MrTreev/EngineeringCapstoneProject/README.md

# EngineeringCapstoneProject

RMIT Engineering Capstone Project 2022

An investigation into materials and components for use in wearable technologies and the development of a holistic health monitoring system
