MrTreev/EngineeringCapstoneProject/02ProgressReport/Images/Figure 6.png

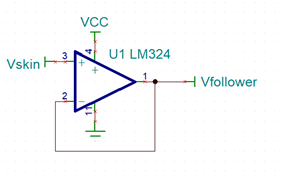
02ProgressReport/Images/Figure 6.png
