MrTreev/EngineeringCapstoneProject/02ProgressReport/Images/Figure 11.png

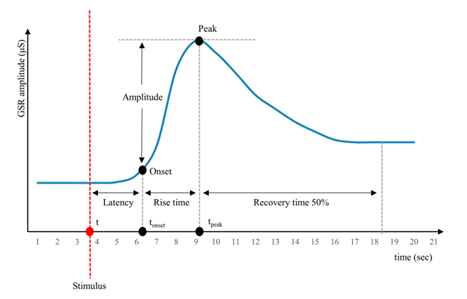
02ProgressReport/Images/Figure 11.png
