MrTreev/EngineeringCapstoneProject/02ProgressReport/Images/Figure 16.jpg

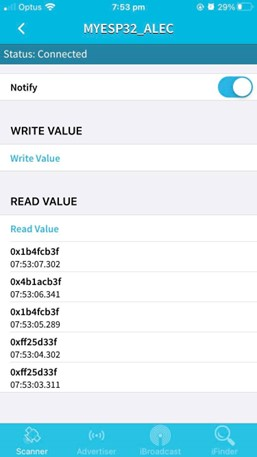
02ProgressReport/Images/Figure 16.jpg
