MrTreev/EngineeringCapstoneProject/02ProgressReport/Images/Figure 18.png

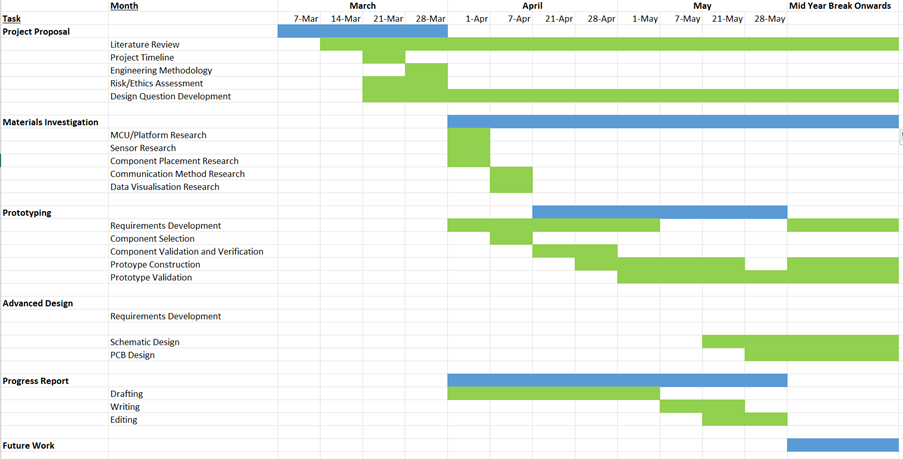
02ProgressReport/Images/Figure 18.png
