MrTreev/EngineeringCapstoneProject/02ProgressReport/Images/Figure 19.png

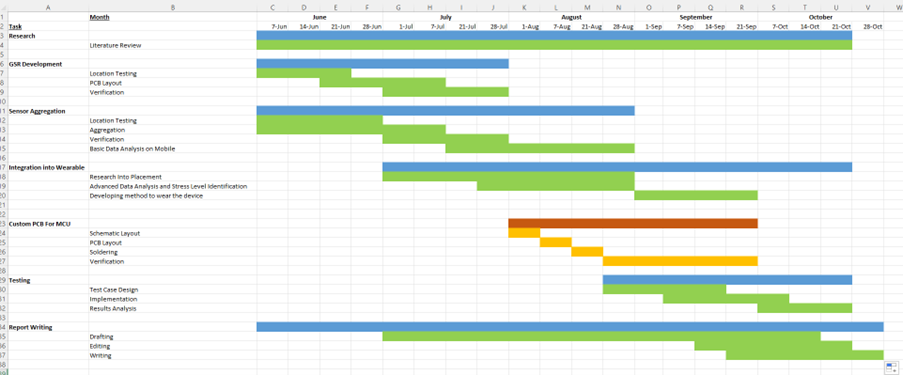
02ProgressReport/Images/Figure 19.png
