MrTreev/EngineeringCapstoneProject/02ProgressReport/Images/MCU Pin Connections.png

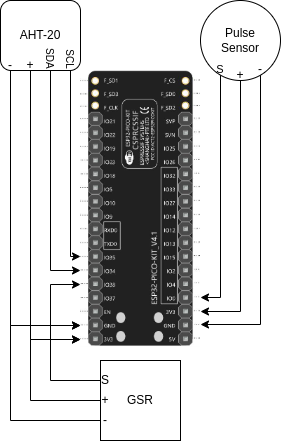
02ProgressReport/Images/MCU Pin Connections.png
