MrTreev/EngineeringCapstoneProject/02ProgressReport/Images/TempAndHumidity.png

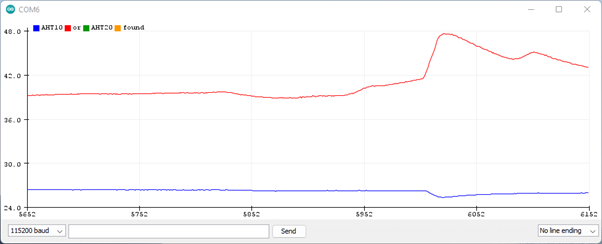
02ProgressReport/Images/TempAndHumidity.png
