MrTreev/EngineeringCapstoneProject/04FinalReport/images/AdvancedPCBBotView.png

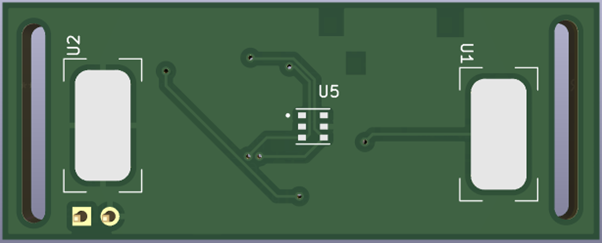
04FinalReport/images/AdvancedPCBBotView.png
