MrTreev/EngineeringCapstoneProject/04FinalReport/images/AdvancedPCBDesign.png

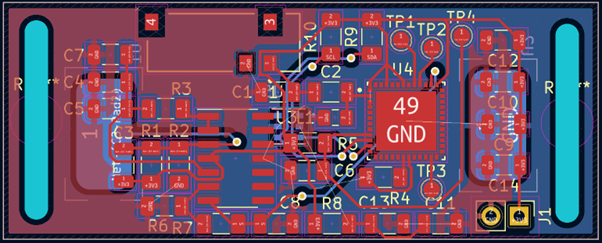
04FinalReport/images/AdvancedPCBDesign.png
