MrTreev/EngineeringCapstoneProject/04FinalReport/images/AdvancedPCBSchematic.png

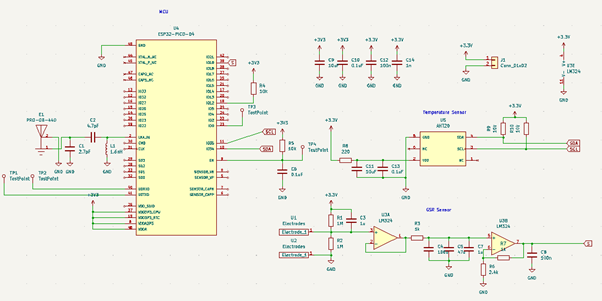
04FinalReport/images/AdvancedPCBSchematic.png
