MrTreev/EngineeringCapstoneProject/04FinalReport/images/AdvancedPCBTopView.png

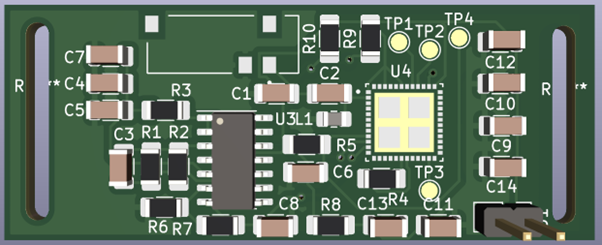
04FinalReport/images/AdvancedPCBTopView.png
