MrTreev/EngineeringCapstoneProject/04FinalReport/images/AHT20TypicalApplication.png

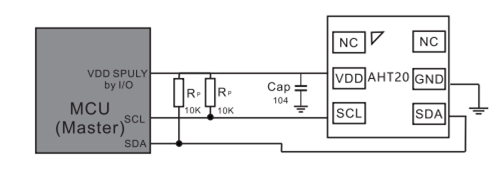
04FinalReport/images/AHT20TypicalApplication.png
