MrTreev/EngineeringCapstoneProject/04FinalReport/images/AmmeterConnection.jpg

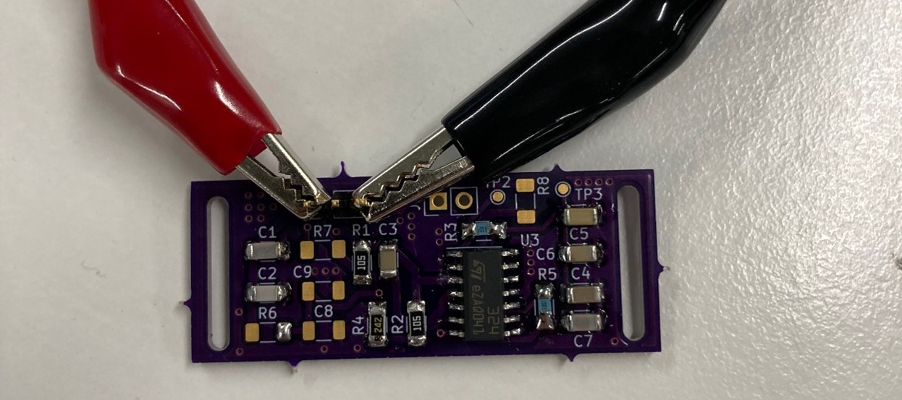
04FinalReport/images/AmmeterConnection.jpg
