MrTreev/EngineeringCapstoneProject/04FinalReport/images/CustomGSRSeeed.png

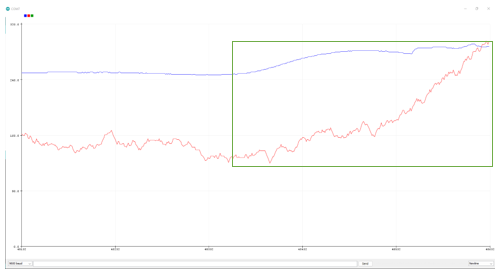
04FinalReport/images/CustomGSRSeeed.png
