MrTreev/EngineeringCapstoneProject/04FinalReport/images/DataPostSnippet.png

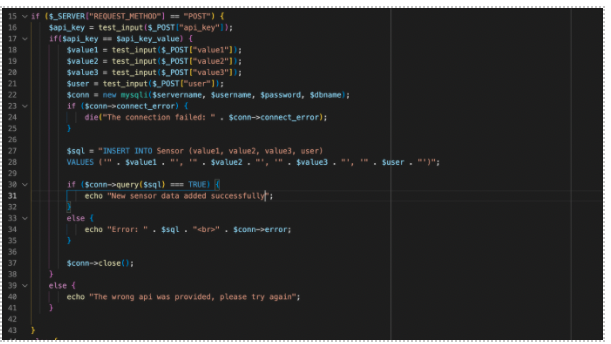
04FinalReport/images/DataPostSnippet.png
