MrTreev/EngineeringCapstoneProject/04FinalReport/images/DeviceBack.png

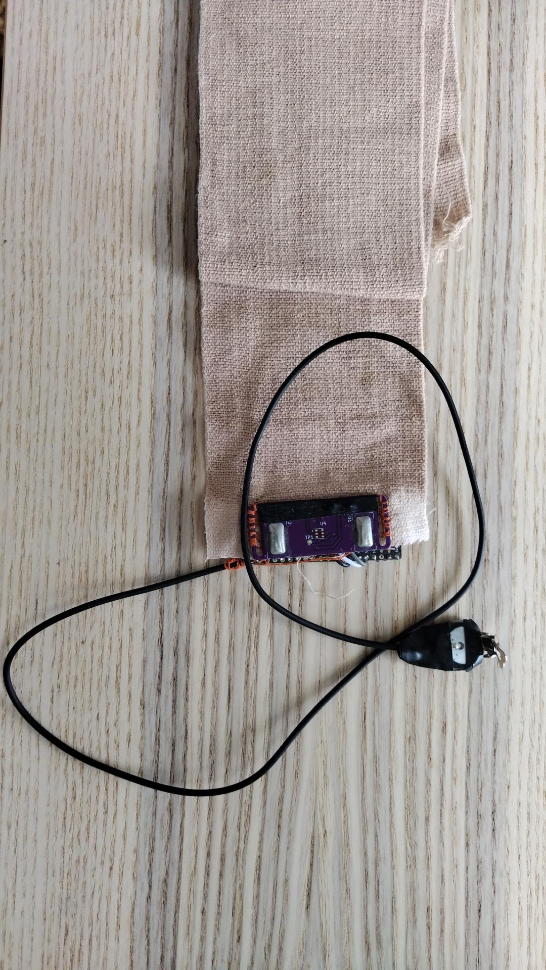
04FinalReport/images/DeviceBack.png
