MrTreev/EngineeringCapstoneProject/04FinalReport/images/DeviceFront.png

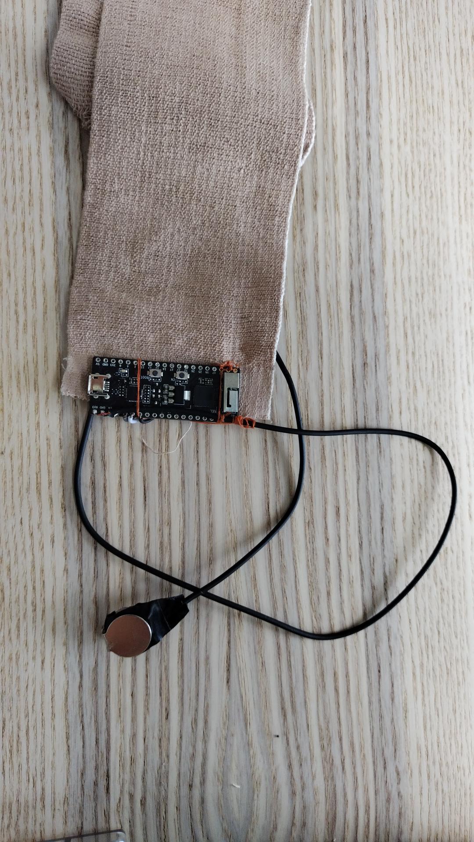
04FinalReport/images/DeviceFront.png
