MrTreev/EngineeringCapstoneProject/04FinalReport/images/DualCoreESP32.png

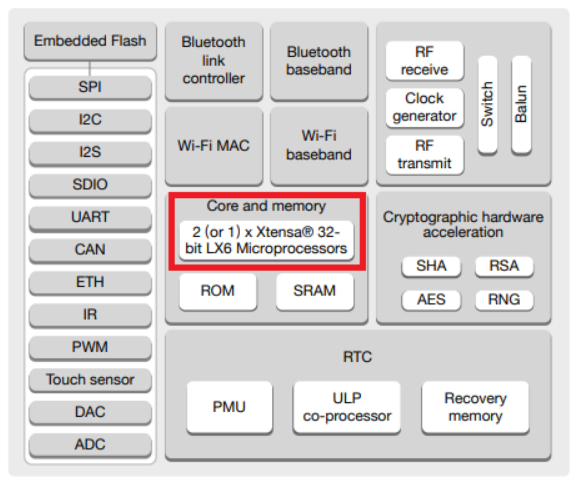
04FinalReport/images/DualCoreESP32.png
