MrTreev/EngineeringCapstoneProject/04FinalReport/images/FigmaDesigns.png

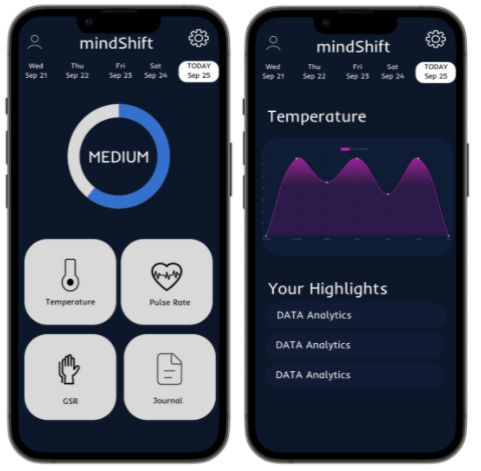
04FinalReport/images/FigmaDesigns.png
