MrTreev/EngineeringCapstoneProject/04FinalReport/images/FinalElectrodes.jpg

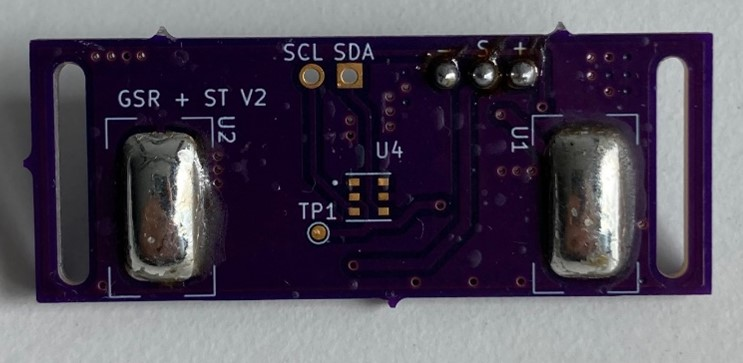
04FinalReport/images/FinalElectrodes.jpg
