MrTreev/EngineeringCapstoneProject/04FinalReport/images/FlexBottomSide.jpg

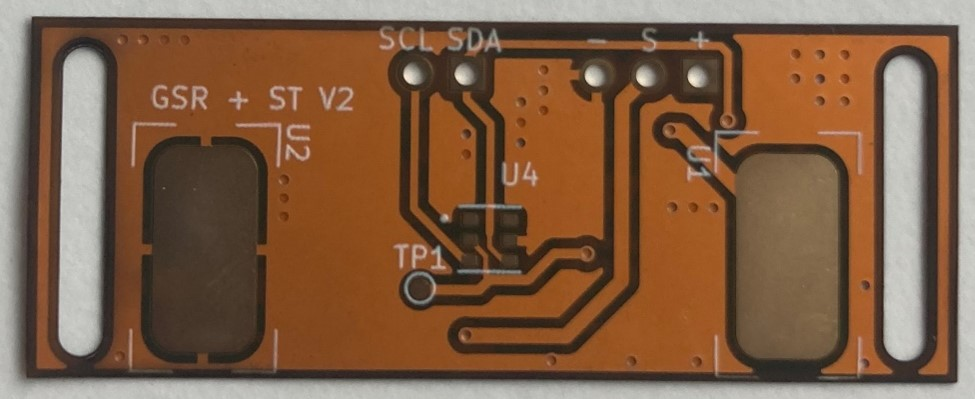
04FinalReport/images/FlexBottomSide.jpg
