MrTreev/EngineeringCapstoneProject/04FinalReport/images/FlexTopSide.jpg

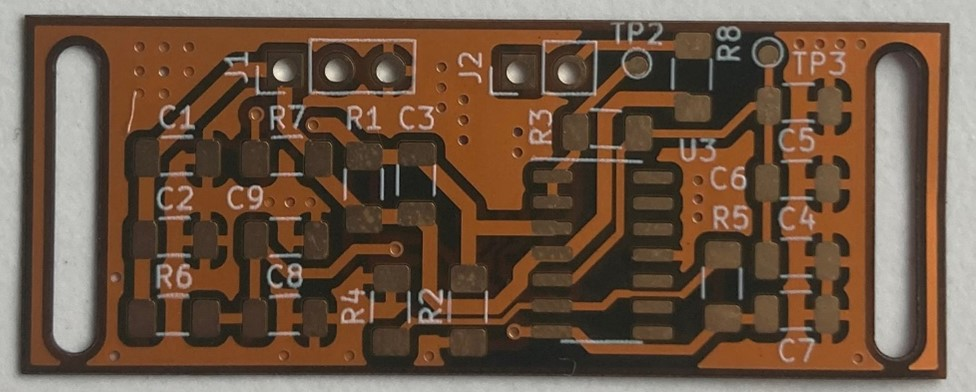
04FinalReport/images/FlexTopSide.jpg
