MrTreev/EngineeringCapstoneProject/04FinalReport/images/GenericBotView.png

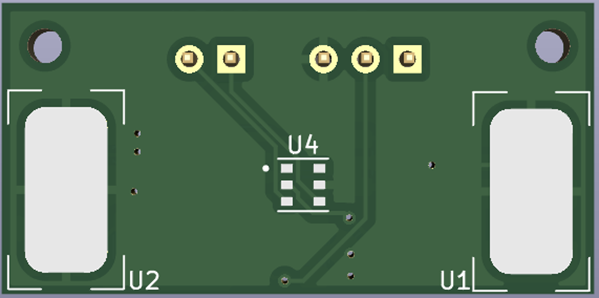
04FinalReport/images/GenericBotView.png
