MrTreev/EngineeringCapstoneProject/04FinalReport/images/GenericMountingHoles.png

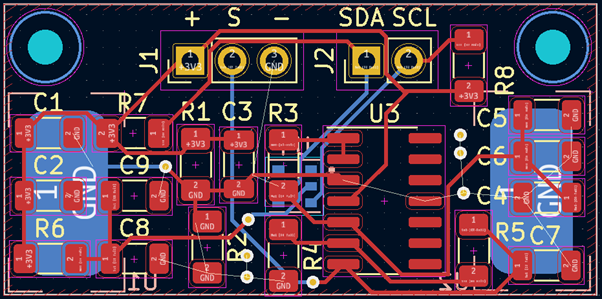
04FinalReport/images/GenericMountingHoles.png
