MrTreev/EngineeringCapstoneProject/04FinalReport/images/GenericTopView.png

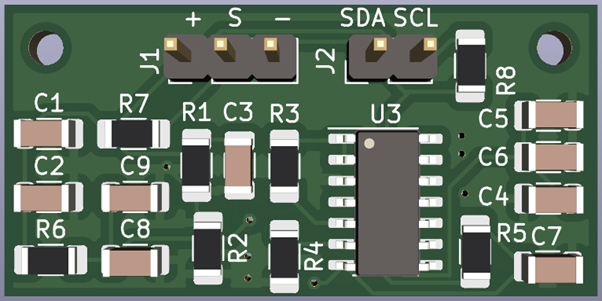
04FinalReport/images/GenericTopView.png
