MrTreev/EngineeringCapstoneProject/04FinalReport/images/GroundPlanes.png

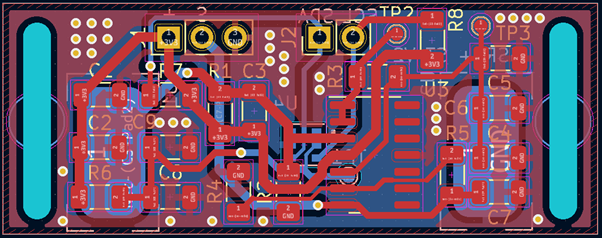
04FinalReport/images/GroundPlanes.png
