MrTreev/EngineeringCapstoneProject/04FinalReport/images/HighLevelSystemDesign.png

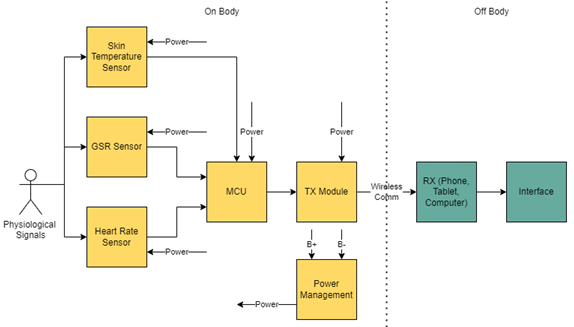
04FinalReport/images/HighLevelSystemDesign.png
