MrTreev/EngineeringCapstoneProject/04FinalReport/images/KiCadSchematic.png

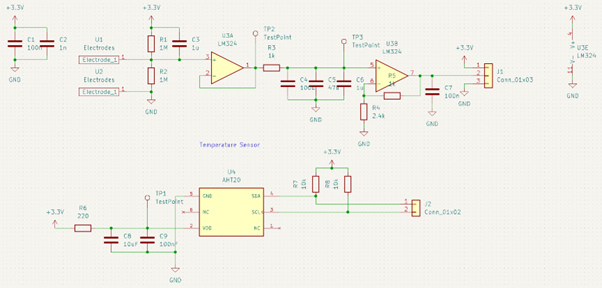
04FinalReport/images/KiCadSchematic.png
