MrTreev/EngineeringCapstoneProject/04FinalReport/images/PCBDesignProcess.png

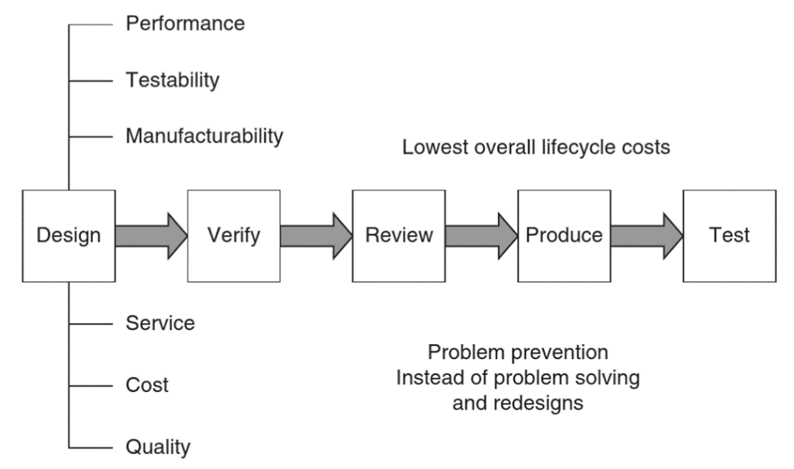
04FinalReport/images/PCBDesignProcess.png
