MrTreev/EngineeringCapstoneProject/04FinalReport/images/PogoPinExample.png

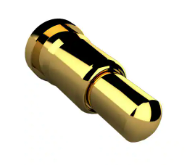
04FinalReport/images/PogoPinExample.png
