MrTreev/EngineeringCapstoneProject/04FinalReport/images/PositioningEarLobe.png

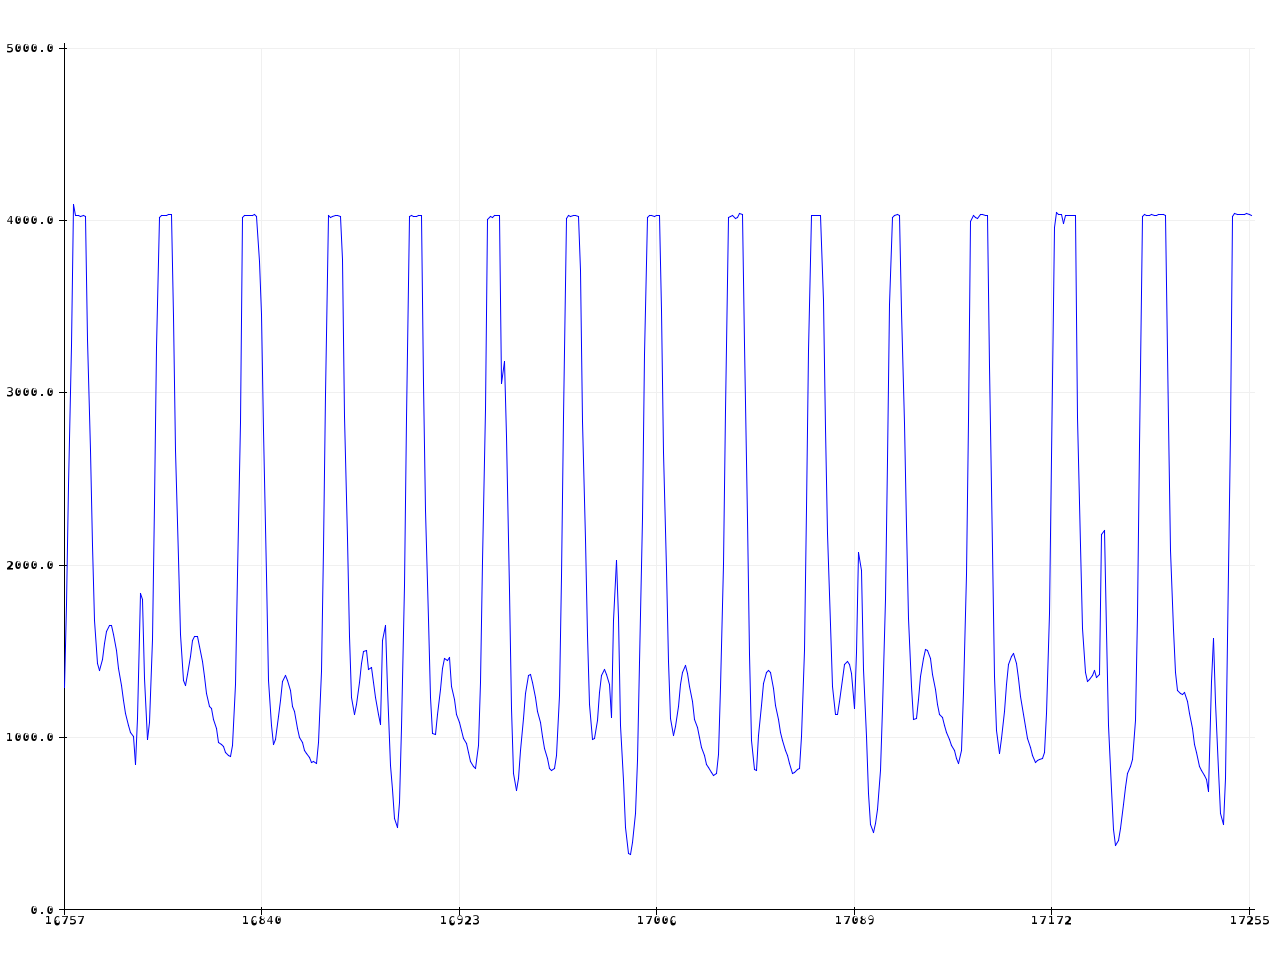
04FinalReport/images/PositioningEarLobe.png
