MrTreev/EngineeringCapstoneProject/04FinalReport/images/PositioningEarLobeMovement.png

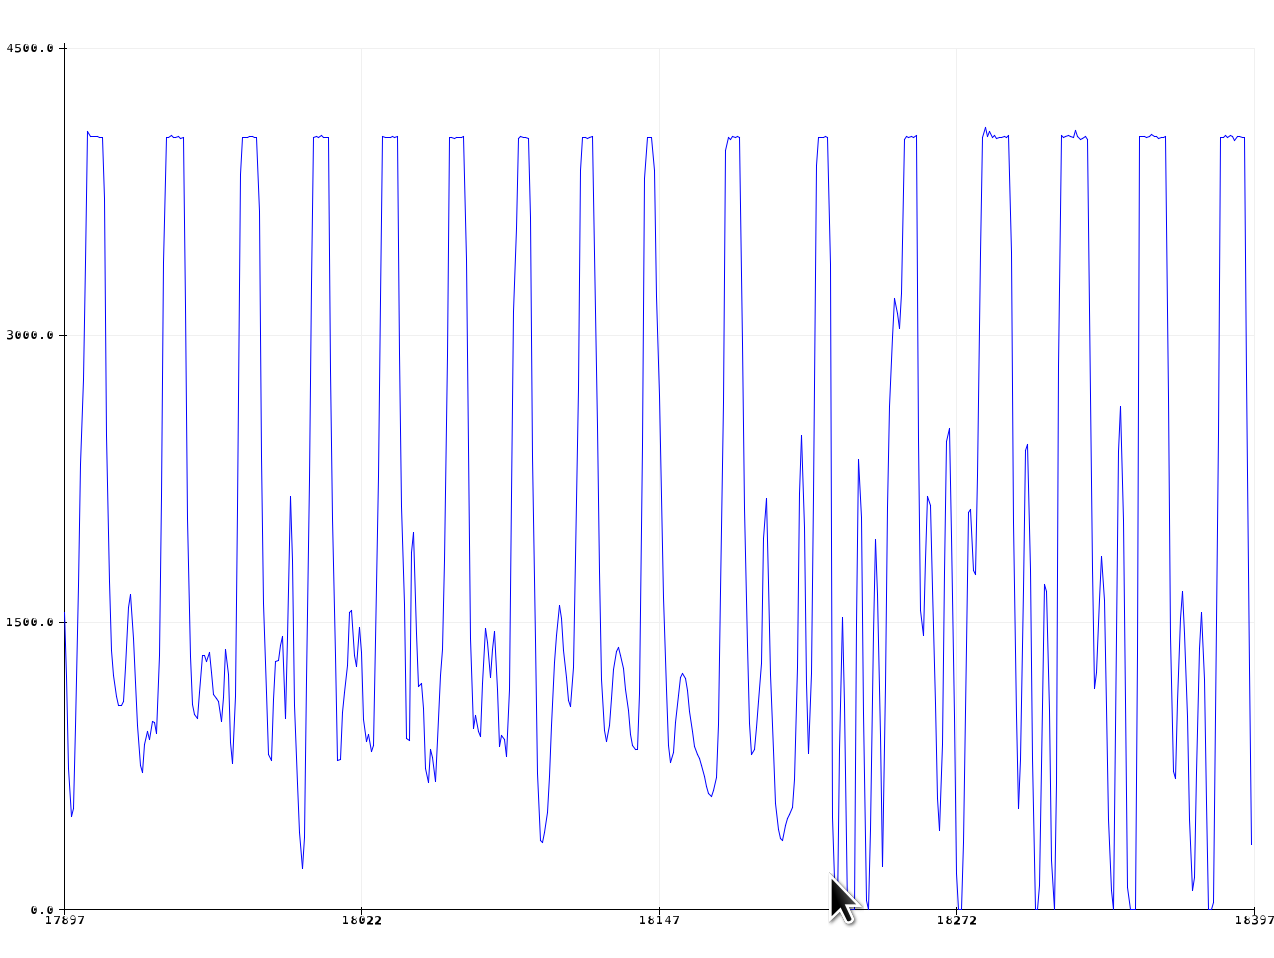
04FinalReport/images/PositioningEarLobeMovement.png
