MrTreev/EngineeringCapstoneProject/04FinalReport/images/PositioningElbow.png

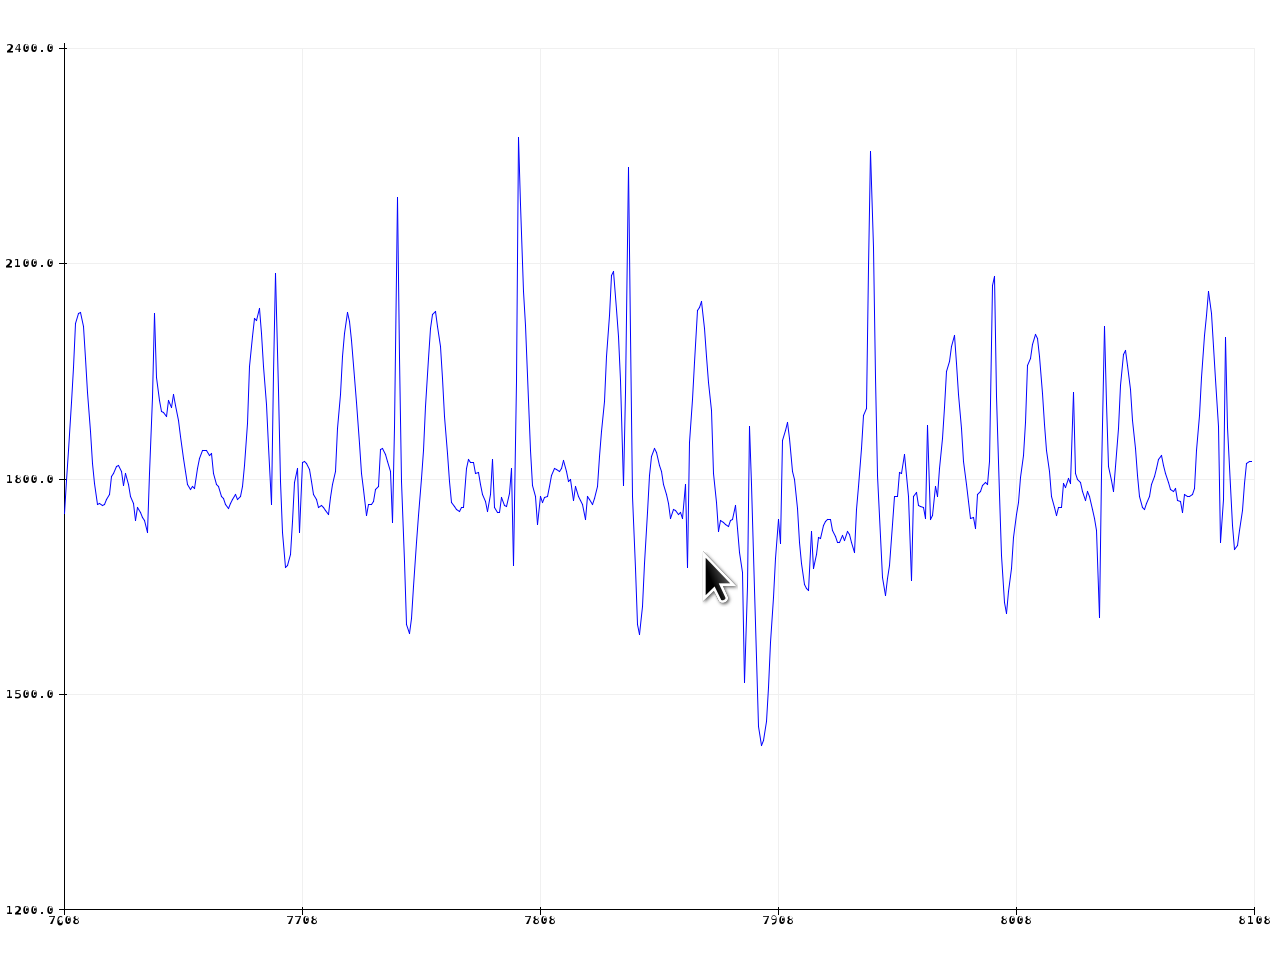
04FinalReport/images/PositioningElbow.png
