MrTreev/EngineeringCapstoneProject/04FinalReport/images/PositioningMidArmMovement.png

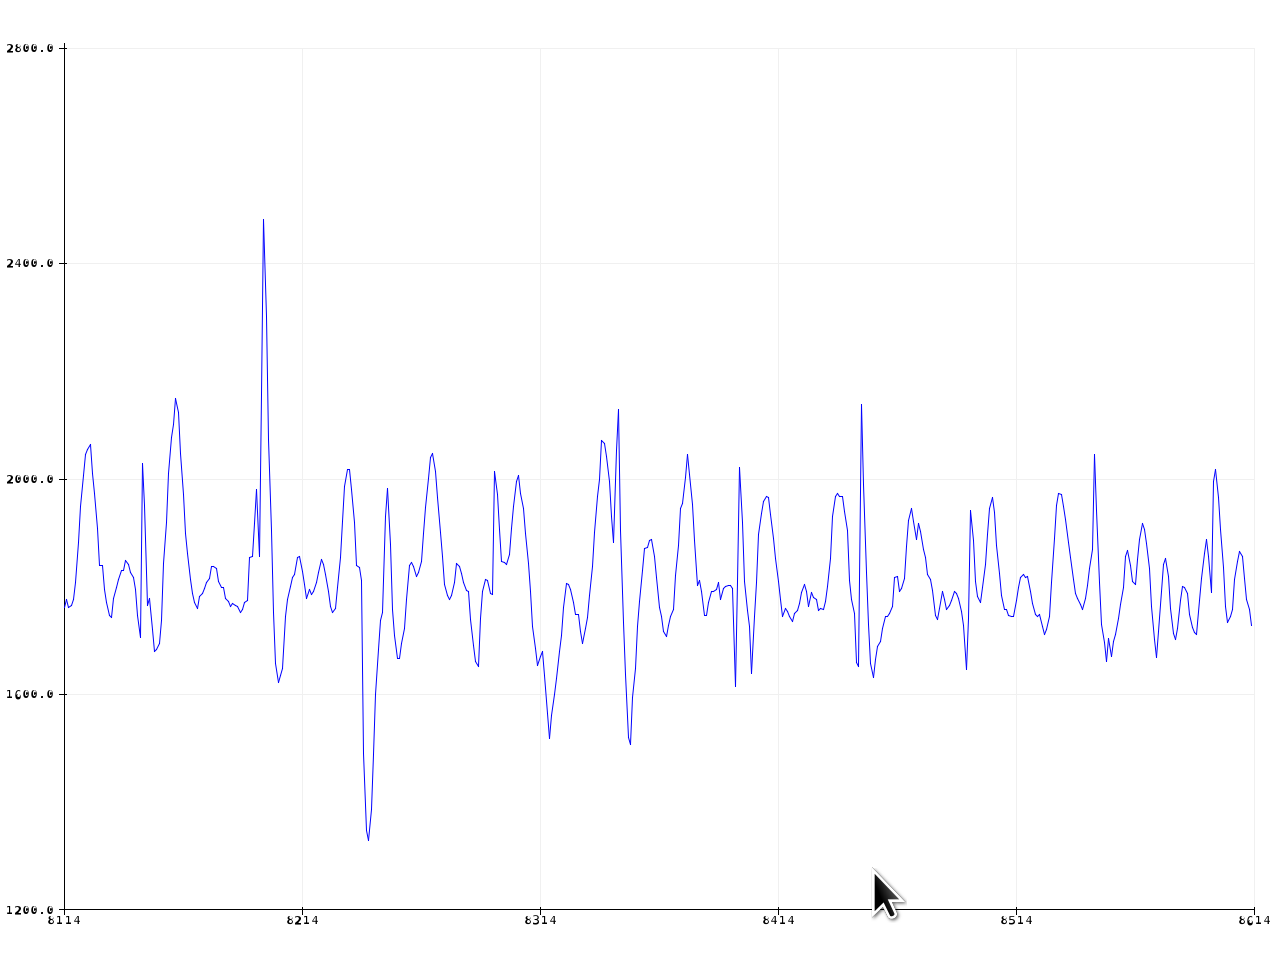
04FinalReport/images/PositioningMidArmMovement.png
