MrTreev/EngineeringCapstoneProject/04FinalReport/images/PositioningWristMildMovement.png

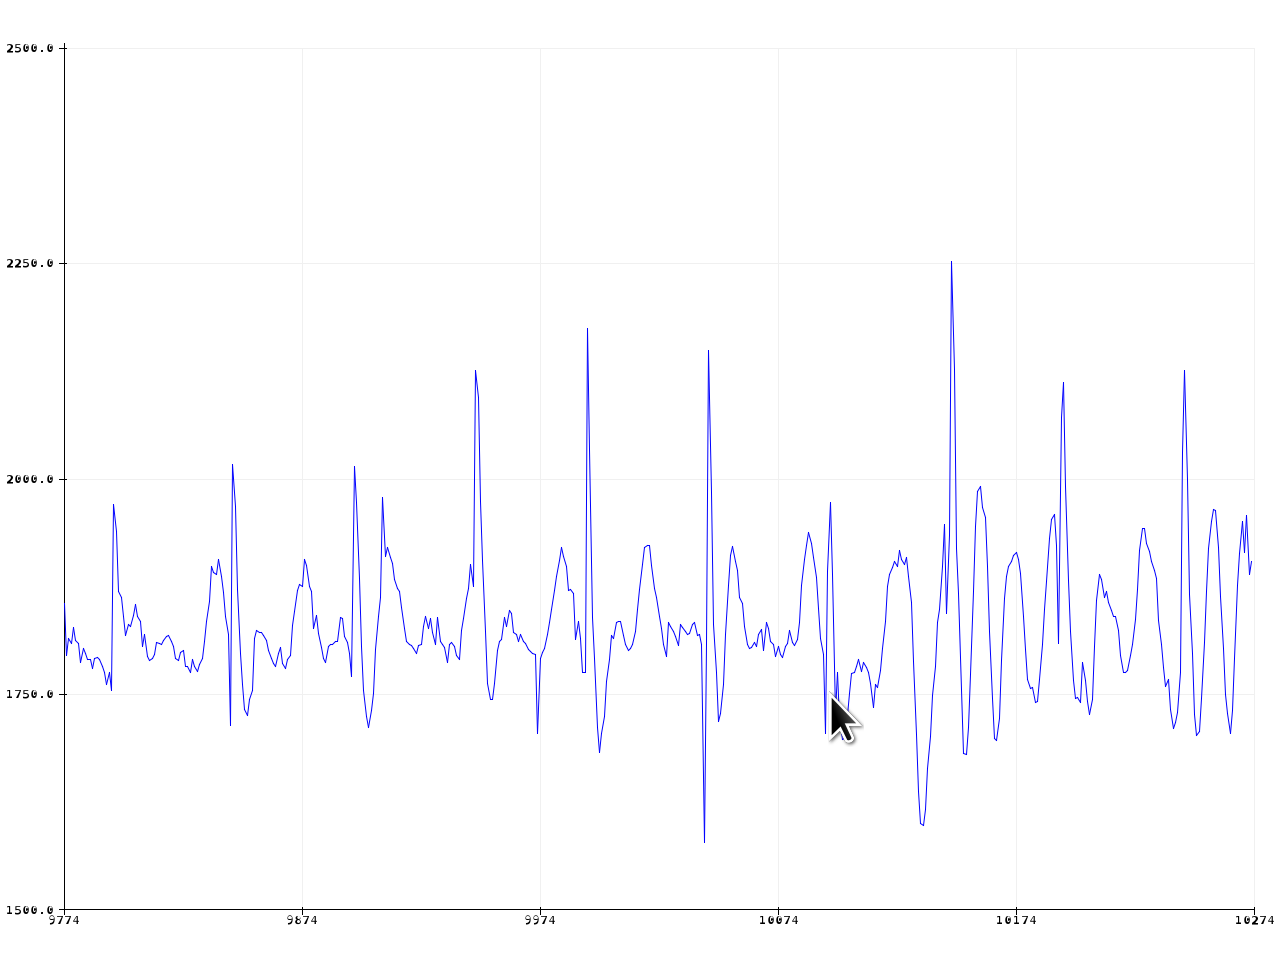
04FinalReport/images/PositioningWristMildMovement.png
