MrTreev/EngineeringCapstoneProject/04FinalReport/images/PowerSupplyAndAmmeter.jpg

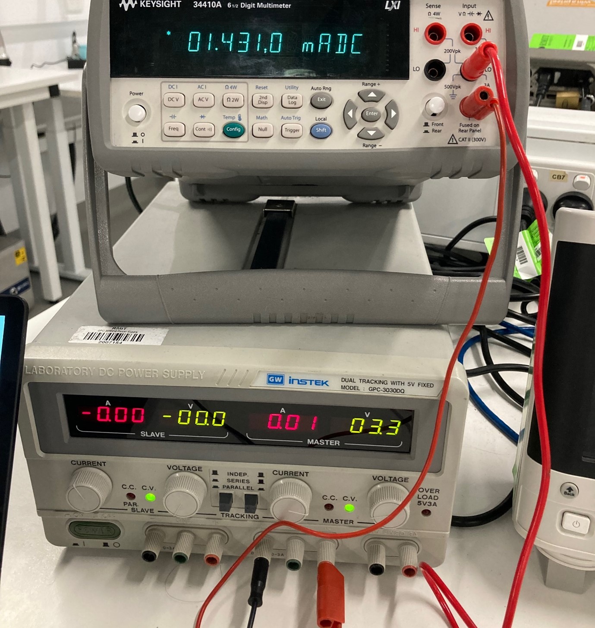
04FinalReport/images/PowerSupplyAndAmmeter.jpg
