MrTreev/EngineeringCapstoneProject/04FinalReport/images/PrototypeSchematic.png

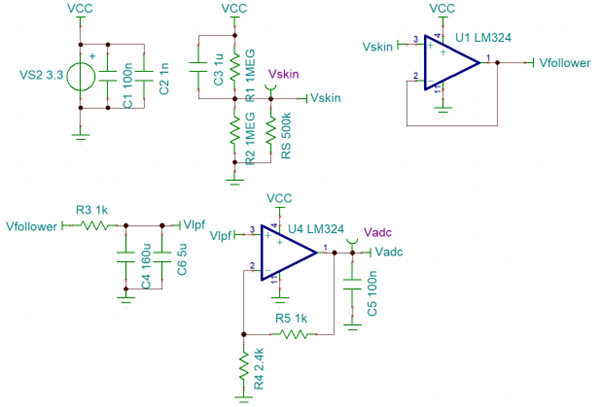
04FinalReport/images/PrototypeSchematic.png
