MrTreev/EngineeringCapstoneProject/04FinalReport/images/RawPulseBPM.png

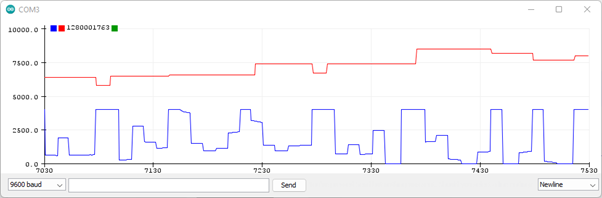
04FinalReport/images/RawPulseBPM.png
