MrTreev/EngineeringCapstoneProject/04FinalReport/images/RigidBottomSide.jpg

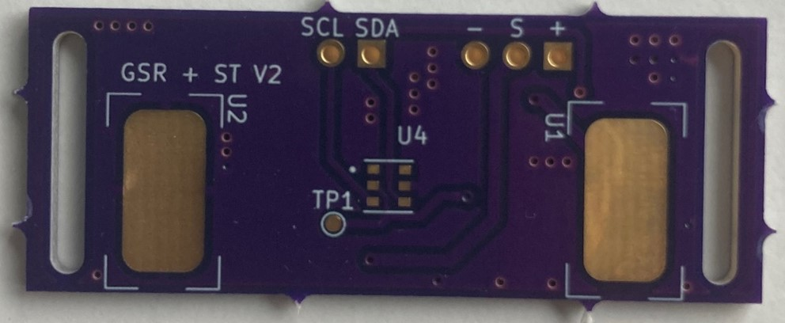
04FinalReport/images/RigidBottomSide.jpg
