MrTreev/EngineeringCapstoneProject/04FinalReport/images/RigidTopSide.jpg

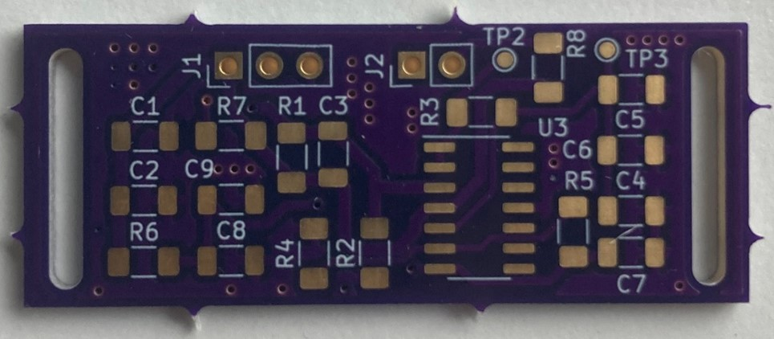
04FinalReport/images/RigidTopSide.jpg
