MrTreev/EngineeringCapstoneProject/04FinalReport/images/RootCausePCBAnalysis.png

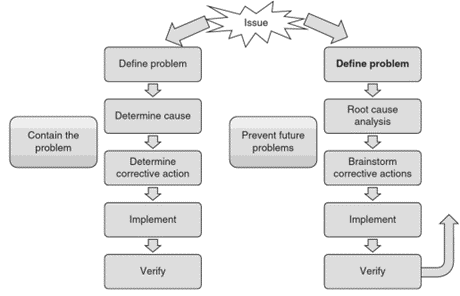
04FinalReport/images/RootCausePCBAnalysis.png
