MrTreev/EngineeringCapstoneProject/04FinalReport/images/SampleDataFromDatabase.png

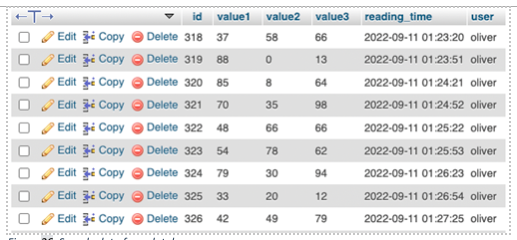
04FinalReport/images/SampleDataFromDatabase.png
