MrTreev/EngineeringCapstoneProject/04FinalReport/images/SchematicToPCB.png

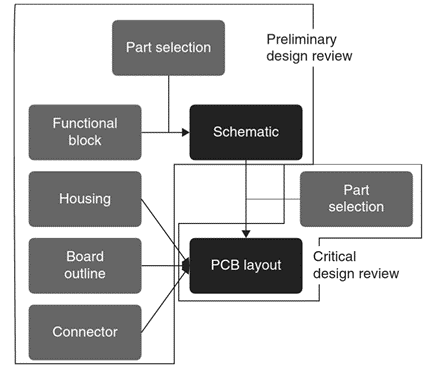
04FinalReport/images/SchematicToPCB.png
