MrTreev/EngineeringCapstoneProject/04FinalReport/images/SoftwareArchitectureFlowchart.png

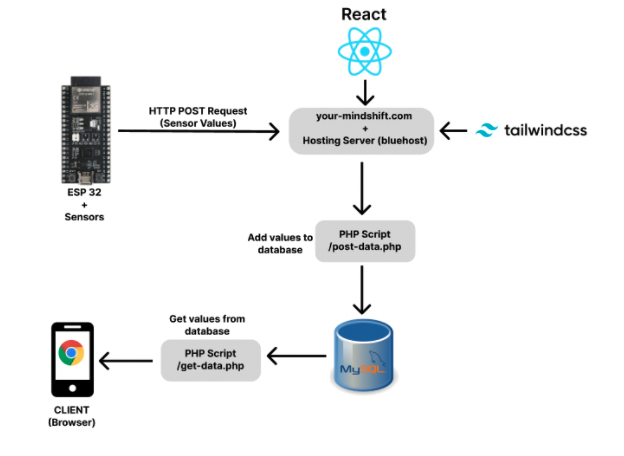
04FinalReport/images/SoftwareArchitectureFlowchart.png
