MrTreev/EngineeringCapstoneProject/04FinalReport/images/StrapBotView.png

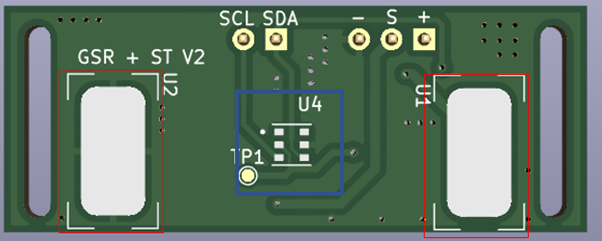
04FinalReport/images/StrapBotView.png
