MrTreev/EngineeringCapstoneProject/04FinalReport/images/StrapMountingHoles.png

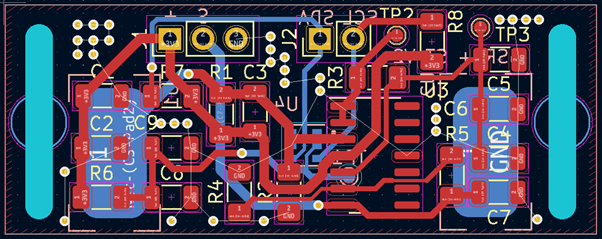
04FinalReport/images/StrapMountingHoles.png
