MrTreev/EngineeringCapstoneProject/04FinalReport/images/StrapTopView.png

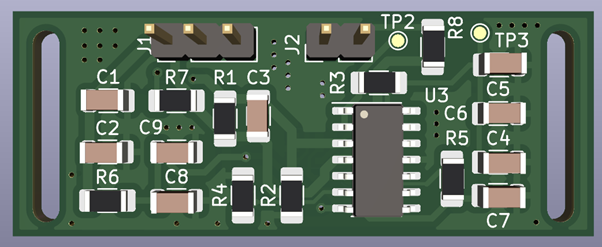
04FinalReport/images/StrapTopView.png
