MrTreev/EngineeringCapstoneProject/04FinalReport/images/WornDevice.jpg

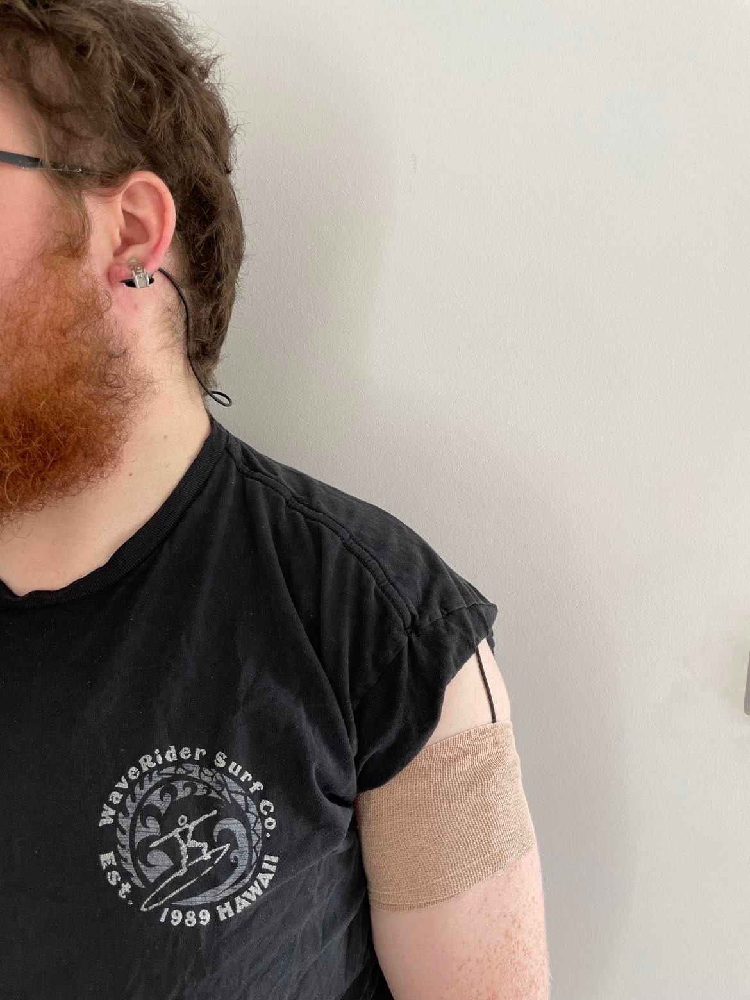
04FinalReport/images/WornDevice.jpg
