MrTreev/EngineeringCapstoneProject/Resources/Datasheets/ESP32-PICO/1_195329ba3fc.jpg

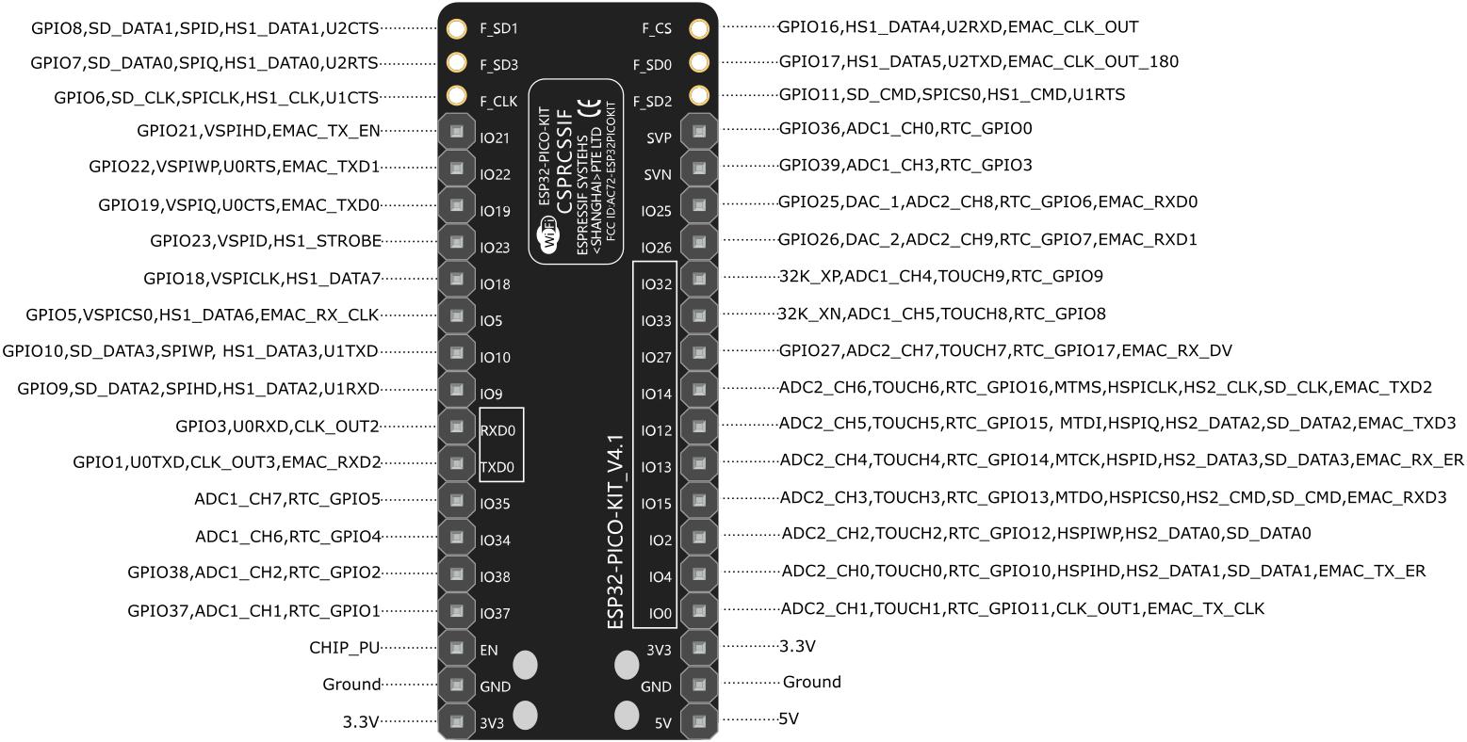
Resources/Datasheets/ESP32-PICO/1_195329ba3fc.jpg
