MrTreev/EngineeringCapstoneProject/Resources/Datasheets/ESP32-PICO/ProtocolDiagram.png

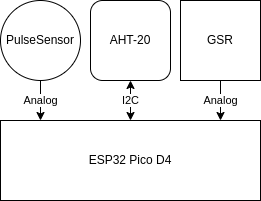
Resources/Datasheets/ESP32-PICO/ProtocolDiagram.png
