MrTreev/EngineeringCapstoneProject/Resources/Papers/SYmpathetic-vs-parasympathetic-1.jpg

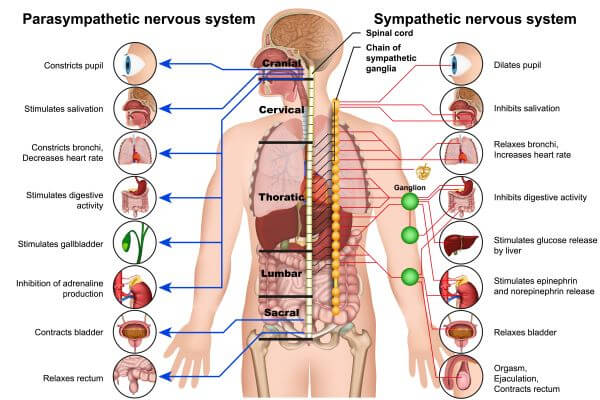
Resources/Papers/SYmpathetic-vs-parasympathetic-1.jpg
