MrTreev/EngineeringCapstoneProject/04FinalReport/images/ReactComponentTree.png

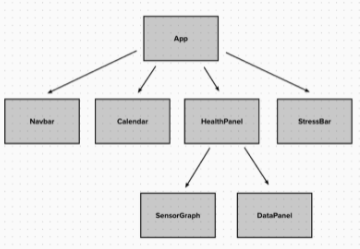
04FinalReport/images/ReactComponentTree.png
