MrTreev/EngineeringCapstoneProject/Resources/Datasheets/ESP32-PICO/WiringDiagram.png

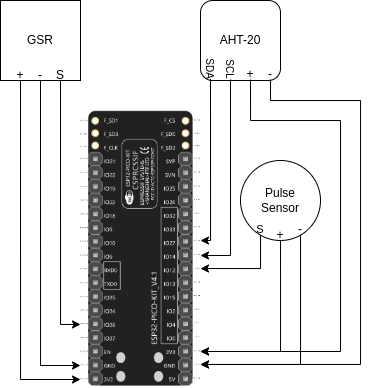
Resources/Datasheets/ESP32-PICO/WiringDiagram.png
