MrTreev/EngineeringCapstoneProject/Testing/Matlab/SensorDataTest2.csv

20013 | 342.00 | 1153 | 0 | 2022-10-10 18:23:35 | oliver
20014 | 857.00 | 120 | 0 | 2022-10-10 18:23:42 | oliver
20015 | 850.00 | 126 | 0 | 2022-10-10 18:23:49 | oliver
20016 | 842.00 | 121 | 0 | 2022-10-10 18:23:56 | oliver
20017 | 835.00 | 128 | 0 | 2022-10-10 18:24:03 | oliver
20018 | 829.00 | 126 | 0 | 2022-10-10 18:24:10 | oliver
20019 | 823.00 | 128 | 0 | 2022-10-10 18:24:17 | oliver
20020 | 822.00 | 118 | 0 | 2022-10-10 18:24:23 | oliver
20021 | 819.00 | 109 | 0 | 2022-10-10 18:24:30 | oliver
20022 | 815.00 | 126 | 0 | 2022-10-10 18:24:37 | oliver
20023 | 817.00 | 111 | 0 | 2022-10-10 18:24:44 | oliver
20024 | 808.00 | 131 | 0 | 2022-10-10 18:24:51 | oliver
20025 | 812.00 | 125 | 0 | 2022-10-10 18:24:57 | oliver
20026 | 816.00 | 129 | 0 | 2022-10-10 18:25:04 | oliver
20027 | 815.00 | 130 | 0 | 2022-10-10 18:25:11 | oliver
20028 | 817.00 | 103 | 0 | 2022-10-10 18:25:18 | oliver
20029 | 816.00 | 134 | 0 | 2022-10-10 18:25:25 | oliver
20030 | 815.00 | 123 | 0 | 2022-10-10 18:25:32 | oliver
20031 | 814.00 | 109 | 0 | 2022-10-10 18:25:39 | oliver
20032 | 819.00 | 107 | 0 | 2022-10-10 18:25:46 | oliver
20033 | 817.00 | 120 | 0 | 2022-10-10 18:25:52 | oliver
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
