MrTreev/EngineeringCapstoneProject/Testing/Matlab/SensorDataTest.csv

318 | 37 | 58 | 66 | 2022-09-11 01:23:20 | oliver
319 | 88 | 0 | 13 | 2022-09-11 01:23:51 | oliver
320 | 85 | 8 | 64 | 2022-09-11 01:24:21 | oliver
321 | 70 | 35 | 98 | 2022-09-11 01:24:52 | oliver
322 | 48 | 66 | 66 | 2022-09-11 01:25:22 | oliver
323 | 54 | 78 | 62 | 2022-09-11 01:25:53 | oliver
324 | 79 | 30 | 94 | 2022-09-11 01:26:23 | oliver
325 | 33 | 20 | 12 | 2022-09-11 01:26:54 | oliver
326 | 42 | 49 | 79 | 2022-09-11 01:27:25 | oliver
327 | 79 | 23 | 48 | 2022-09-11 01:27:55 | oliver
328 | 12 | 8 | 17 | 2022-09-11 01:28:26 | oliver
329 | 56 | 58 | 36 | 2022-09-11 01:28:57 | oliver
330 | 13 | 74 | 27 | 2022-09-11 02:02:25 | oliver
331 | 89 | 34 | 3 | 2022-09-11 02:03:21 | oliver
332 | 3 | 18 | 4 | 2022-09-11 02:03:52 | oliver
333 | 59 | 7 | 3 | 2022-09-11 02:34:42 | oliver
334 | 58 | 12 | 89 | 2022-09-11 02:35:30 | oliver
335 | 16 | 96 | 2 | 2022-09-11 02:36:00 | oliver
336 | 76 | 65 | 71 | 2022-09-11 02:45:20 | oliver
337 | 32 | 79 | 14 | 2022-09-11 02:46:22 | alec
338 | 98 | 12 | 33 | 2022-09-11 02:46:52 | alec
339 | 98 | 38 | 18 | 2022-09-11 02:47:38 | alec
340 | 85 | 98 | 11 | 2022-09-11 02:47:49 | alec
341 | 17 | 67 | 51 | 2022-09-11 02:48:00 | alec
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
