MrTreev/EngineeringCapstoneProject/04FinalReport/images/BPMVerification.png

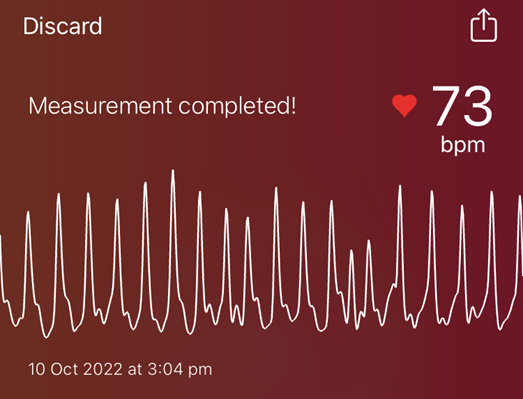
04FinalReport/images/BPMVerification.png
