MrTreev/EngineeringCapstoneProject/04FinalReport/images/Results.png

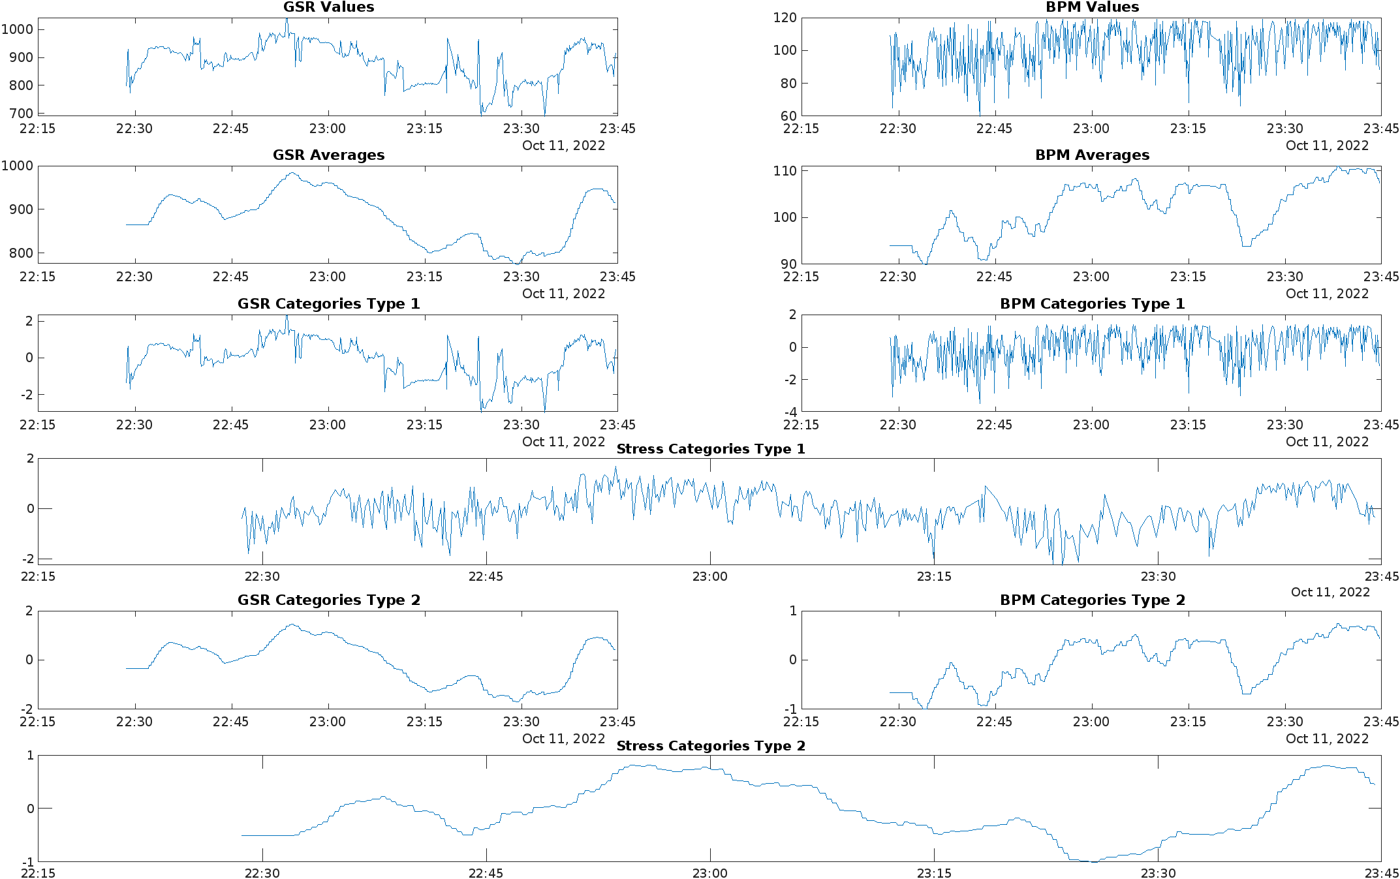
04FinalReport/images/Results.png
