MrTreev/EngineeringCapstoneProject/PCB Files/GSR + ST V2/GSR + ST V2.kicad_pcb

## KiCad design PCB Files/GSR + ST V2/GSR + ST V2.kicad_pcb (2022-08-03)

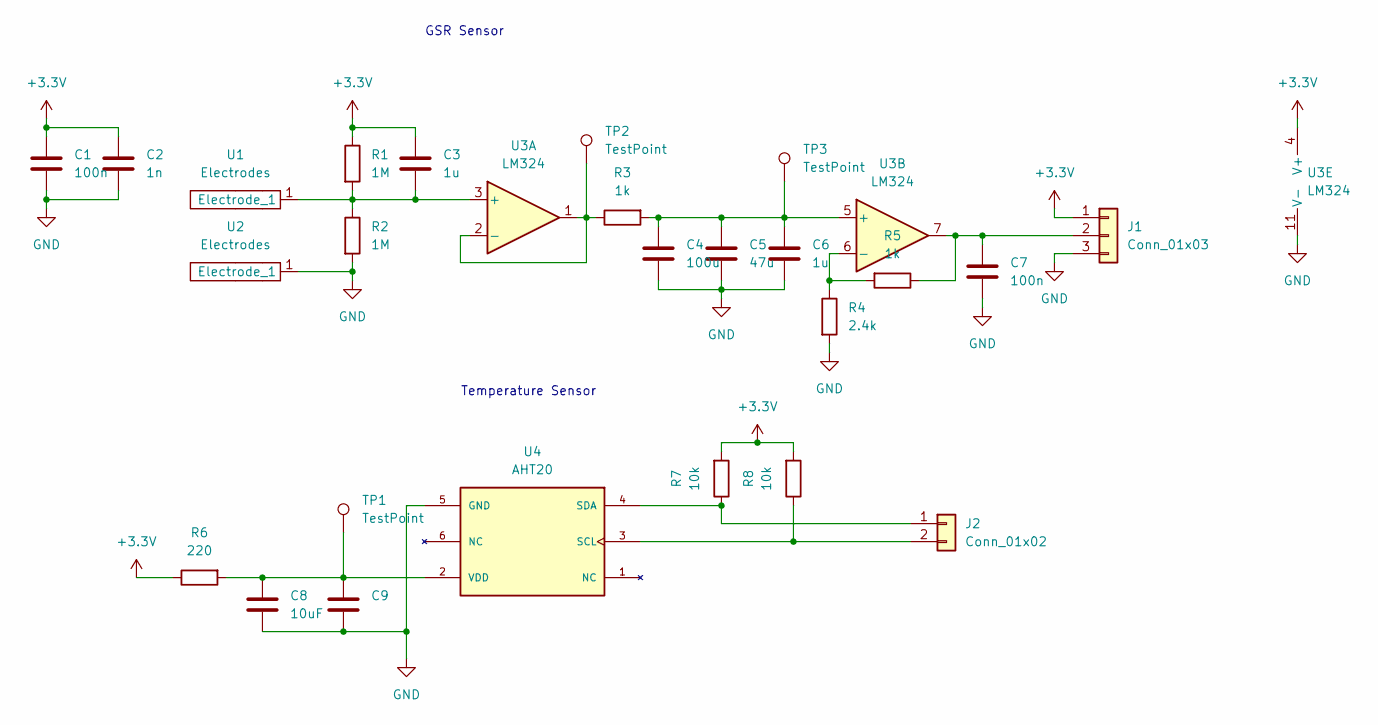
[picture p96: schematic GSR + ST V2.kicad_sch]

Parts:
C1, C7: 100n; C_1206_3216Metric
C2: 1n; C_1206_3216Metric
C3, C6: 1u; C_1206_3216Metric
C4: 100u; C_1206_3216Metric
C5: 47u; C_1206_3216Metric
C8: 10uF; C_1206_3216Metric
C9: C_1206_3216Metric
J1: Conn_01x03; PinHeader_1x03_P2.54mm_Vertical
J2: Conn_01x02; PinHeader_1x02_P2.54mm_Vertical
R1, R2: 1M; R_1206_3216Metric_Pad1.30x1.75mm_HandSolder
R3, R5: 1k; R_1206_3216Metric_Pad1.30x1.75mm_HandSolder
R4: 2.4k; R_1206_3216Metric_Pad1.30x1.75mm_HandSolder
R6: 220; R_1206_3216Metric_Pad1.30x1.75mm_HandSolder
R7, R8: 10k; R_1206_3216Metric_Pad1.30x1.75mm_HandSolder
TP1, TP2, TP3: TestPoint; TestPoint_Pad_D1.0mm
U1, U2: Electrodes; Electrode
U3: LM324; SOIC-14_3.9x8.7mm_P1.27mm
U4: AHT20; PSON100P300X300X110-6N; PARTREV V1.0

Connections:
+3V3: C1.1, C2.1, C3.1, J1.1, R1.1, R6.1, R7.2, R8.2, U3.4 (V+)
GND: C1.2, C2.2, C4.2, C5.2, C6.2, C7.2, C8.2, C9.2, J1.3, R2.2, R4.2, U2.1 (Electrode_1), U3.11 (V-), U4.5 (GND)
unnamed: C3.2, R1.2, R2.1, U1.1 (Electrode_1), U3.3 (+)
unnamed: C4.1, C5.1, C6.1, R3.2, TP3.1, U3.5 (+)
unnamed: C7.1, J1.2, R5.1, U3.7
unnamed: C8.1, C9.1, R6.2, TP1.1, U4.2 (VDD)
unnamed: J2.1, R7.1, U4.4 (SDA)
unnamed: J2.2, R8.1, U4.3 (SCL)
unnamed: R3.1, TP2.1, U3.1, U3.2 (-)
unnamed: R4.1, R5.2, U3.6 (-)

Notes on the sheet:
Temperature Sensor
GSR Sensor

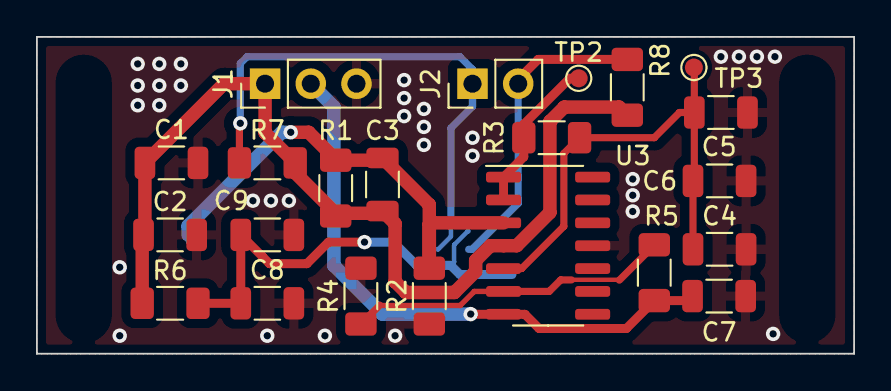
[picture p97: board GSR + ST V2.kicad_pcb from above]

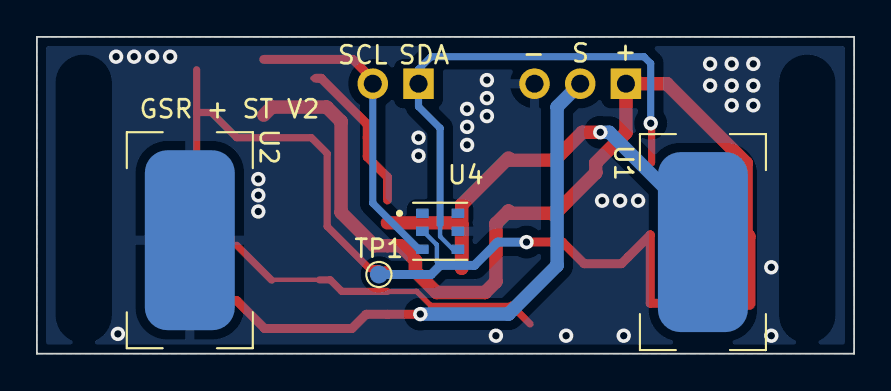
[picture p98: board GSR + ST V2.kicad_pcb from below]

Board: 2 copper layers, 45.4 x 17.6 mm, 26 parts (4 on the bottom side), 10 nets.
