MrTreev/EngineeringCapstoneProject/PCB Files/ESP32 PCB/ESP32 PCB.kicad_pcb

## KiCad design PCB Files/ESP32 PCB/ESP32 PCB.kicad_pcb (2022-08-01)

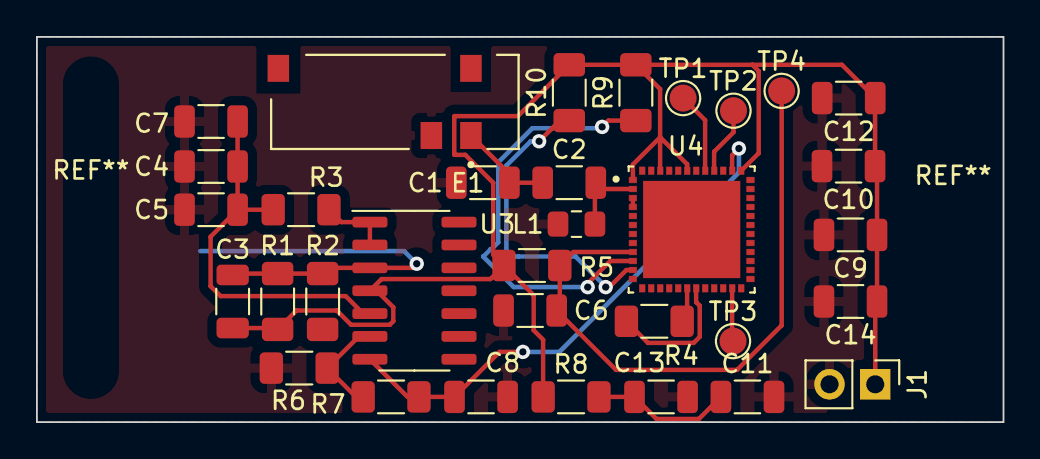
[picture p99: board ESP32 PCB.kicad_pcb from above]

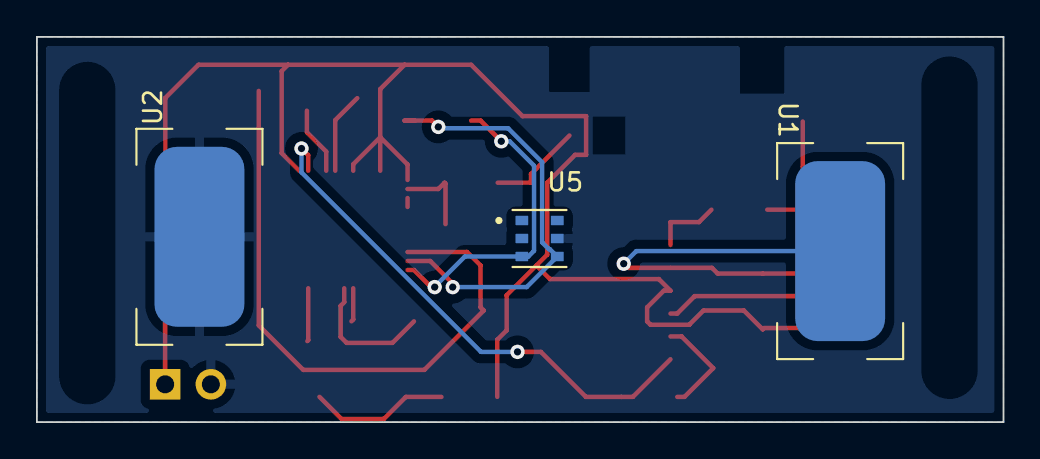
[picture p100: board ESP32 PCB.kicad_pcb from below]

Board: 2 copper layers, 53.7 x 21.4 mm, 36 parts (3 on the bottom side), 17 nets.

Parts:
C1: 2.7pF; C_1206_3216Metric
C2: 4.7pF; C_1206_3216Metric
C3, C7: 1u; C_1206_3216Metric
C4: 100u; C_1206_3216Metric
C5: 47u; C_1206_3216Metric
C6, C10, C13: 0.1uF; C_1206_3216Metric
C8, C12: 100n; C_1206_3216Metric
C9, C11: 10uF; C_1206_3216Metric
C14: 1n; C_1206_3216Metric
E1: PRO-OB-440; ANT_PRO-OB-440
J1: Conn_01x02; PinHeader_1x02_P2.54mm_Vertical
L1: 1.6nH; L_0805_2012Metric_Pad1.15x1.40mm_HandSolder
R1, R2: 1M; R_1206_3216Metric_Pad1.30x1.75mm_HandSolder
R3, R7: 1k; R_1206_3216Metric_Pad1.30x1.75mm_HandSolder
R4, R5: 10K; R_1206_3216Metric_Pad1.30x1.75mm_HandSolder
R6: 2.4k; R_1206_3216Metric_Pad1.30x1.75mm_HandSolder
R8: 220; R_1206_3216Metric_Pad1.30x1.75mm_HandSolder
R9, R10: 10k; R_1206_3216Metric_Pad1.30x1.75mm_HandSolder
TP1, TP2, TP3, TP4: TestPoint; TestPoint_Pad_D1.5mm
U1, U2: Electrodes; Electrode
U3: LM324; SOIC-14_3.9x8.7mm_P1.27mm
U4: ESP32-PICO-D4; PQFN50P700X700X104-49N
U5: AHT20; PSON100P300X300X110-6N

Connections:
+3V3: C3.1, C9.1, C10.1, C12.1, C14.1, J1.1, R1.1, R4.1, R5.1, R8.1, R9.2, R10.2, U3.4 (V+), U4.1 (VDDA), U4.3 (VDDA3P3), U4.4 (VDDA3P3), U4.19 (VDD3P3_RTC), U4.37 (VDD3P3_CPU), U4.43 (VDDA), U4.46 (VDDA)
GND: C1.1, C4.2, C5.2, C6.2, C7.2, C8.2, C9.2, C10.2, C11.2, C12.2, C13.2, C14.2, E1.2, J1.2, L1.1, R2.2, R6.2, U2.1 (Electrode_1), U3.11 (V-), U4.49 (GND), U5.5 (GND)
unnamed: C1.2, C2.1, E1.1
unnamed: C2.2, L1.2, U4.2 (LNA_IN)
unnamed: C3.2, R1.2, R2.1, U1.1 (Electrode_1), U3.3 (+)
unnamed: C4.1, C5.1, C7.1, R3.2, U3.5 (+)
unnamed: C6.1, R5.2, TP4.1, U4.9 (EN)
unnamed: C11.1, C13.1, R8.2, U5.2 (VDD)
unnamed: R3.1, U3.1, U3.2 (-)
unnamed: R6.1, R7.2, U3.6 (-)
unnamed: TP1.1, U4.41 (U0TXD)
unnamed: TP2.1, U4.40 (U0RXD)
unnamed: TP3.1, U4.23 (IO0)
unnamed: R4.2, U4.18 (IO12)
S: C8.1, R7.1, U3.7, U4.38 (IO19)
SCL: R10.1, U4.11 (IO35), U5.3 (SCL)
SDA: R9.1, U4.10 (IO34), U5.4 (SDA)
