MrTreev/EngineeringCapstoneProject/Testing/ESP/Sending_Data_to_Thing_Speak/Sending_Data_to_Thing_Speak.ino

#include <WiFi.h>
#include <HTTPClient.h>
#include <esp_adc_cal.h>

#define adcIn 38

int adcResult = 0;
float voltage = 0;

const char* ssid = "SSID";
const char* password = "password";

//Your Domain name with URL path or IP address with path
String serverName = "https://api.thingspeak.com/update?api_key=8COV8VFJPE511FWX&field1=";

// the following variables are unsigned longs because the time, measured in
// milliseconds, will quickly become a bigger number than can be stored in an int.
unsigned long lastTime = 0;
// Timer set to 10 minutes (600000)
//unsigned long timerDelay = 600000;
// Set timer to 5 seconds (5000)
unsigned long timerDelay = 500;

void setup() {
  Serial.begin(115200);

  WiFi.begin(ssid, password);
  Serial.println("Connecting");
  while(WiFi.status() != WL_CONNECTED) {
    delay(500);
    Serial.print(".");
  }
  Serial.println("");
  Serial.print("Connected to WiFi network with IP Address: ");
  Serial.println(WiFi.localIP());

  Serial.println("Timer set to 5 seconds (timerDelay variable), it will take 5 seconds before publishing the first reading.");
}

void loop() {
  //Send an HTTP POST request every 10 minutes
  if ((millis() - lastTime) > timerDelay) {
    //Check WiFi connection status
    if(WiFi.status()== WL_CONNECTED){
      HTTPClient http;

      adcResult = analogRead(adcIn);
      voltage = readAdcCal(adcResult);
      Serial.print("Voltage: ");
      Serial.print(voltage);
      Serial.println("");

      //Serial.println("Pot Value: " + String(potValue));

      String serverPath = serverName + String(voltage);

      // Your Domain name with URL path or IP address with path
      http.begin(serverPath.c_str());

      // Send HTTP GET request
      int httpResponseCode = http.GET();

      if (httpResponseCode>0) {
        //Serial.print("HTTP Response code: ");
        //Serial.println(httpResponseCode);
        String payload = http.getString();
        //Serial.println(payload);
      }
      else {
        Serial.print("Error code: ");
        Serial.println(httpResponseCode);
      }
      // Free resources
      http.end();
    }
    else {
      Serial.println("WiFi Disconnected");
    }
    lastTime = millis();
  }
}

uint32_t readAdcCal(int adcRaw){
  esp_adc_cal_characteristics_t adc_chars;
  esp_adc_cal_characterize(ADC_UNIT_1, ADC_ATTEN_DB_11, ADC_WIDTH_BIT_12, 1100, &adc_chars);
  return(esp_adc_cal_raw_to_voltage(adcRaw, &adc_chars));
}
