MrTreev/EngineeringCapstoneProject/(commit log)

2022-03-26 added sweat sensor papers and references
2022-05-04 read adc and send via ble
2022-05-22 added extra graphs and sensor readers
2022-05-23 Create MCU Pin Connections.png
2022-08-01 Upload PCB Files
    [ESP32 PCB.kicad_pcb, ESP32 PCB.kicad_sch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]
2022-09-12 SW Filtering
2022-09-26 Added Sensor Data File
    [SensorDataTest.csv]
2022-10-16 Finalised Report
    [SensorDataTest2.csv]
